bmoniey/FilamentMeasuringTool/gallery/as5600brd.png

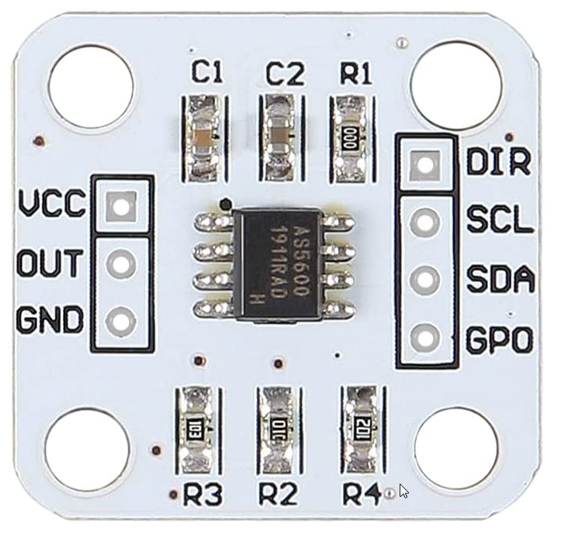
gallery/as5600brd.png
