bmoniey/FilamentMeasuringTool/gallery/display.png

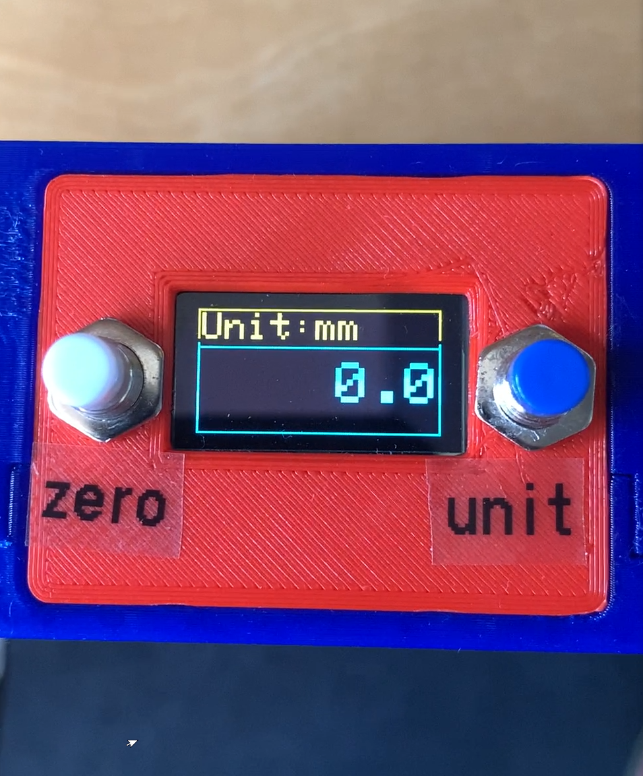
gallery/display.png
