bmoniey/FilamentMeasuringTool/gallery/fmt20_assy1.png

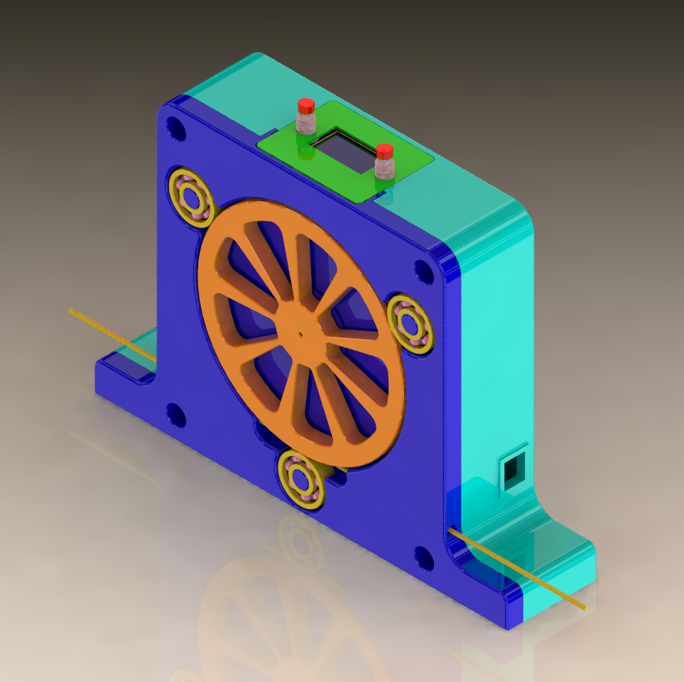
gallery/fmt20_assy1.png
