bmoniey/FilamentMeasuringTool/gallery/fmt20_assy2.png

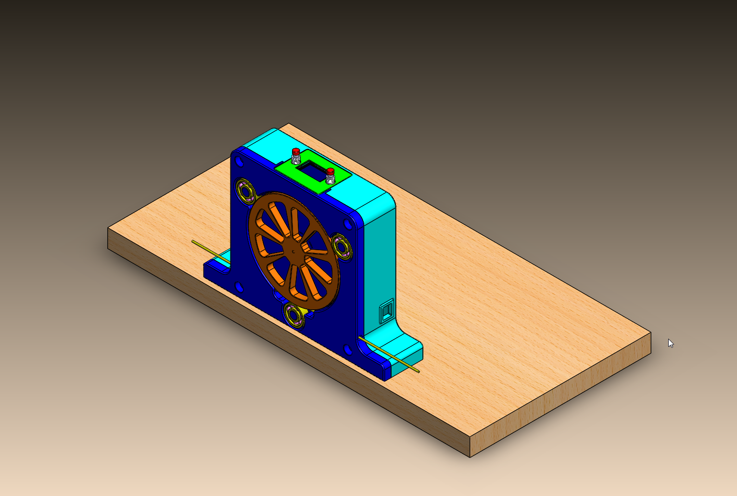
gallery/fmt20_assy2.png
