bmoniey/FilamentMeasuringTool/gallery/fmt20_assy3.png

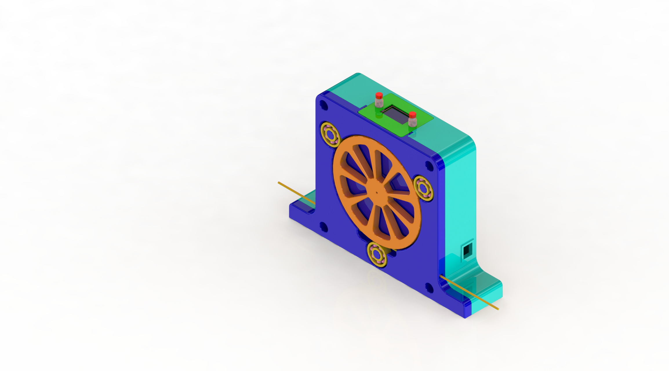
gallery/fmt20_assy3.png
