bmoniey/FilamentMeasuringTool/gallery/IMG_5166.jpg

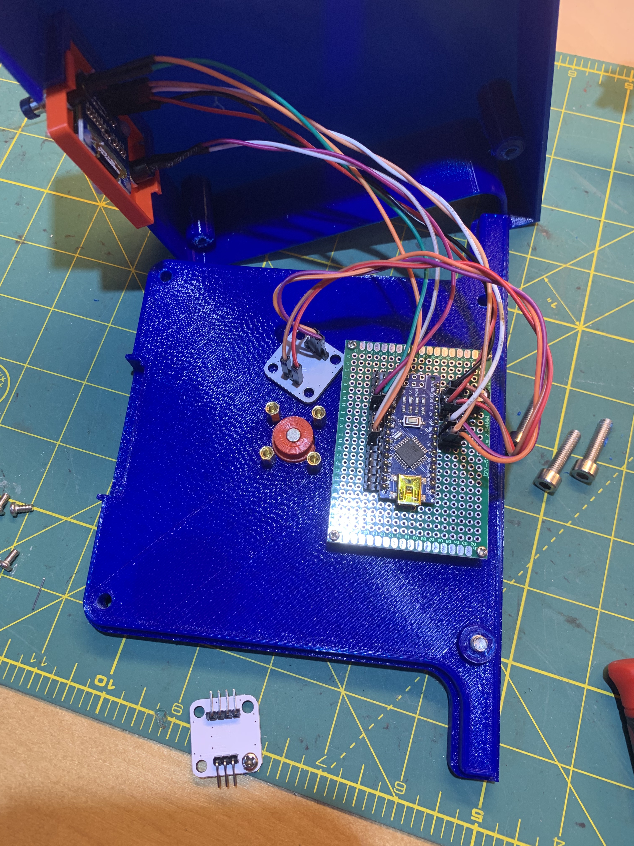
gallery/IMG_5166.jpg
