bmoniey/FilamentMeasuringTool/gallery/IMG_5167.jpg

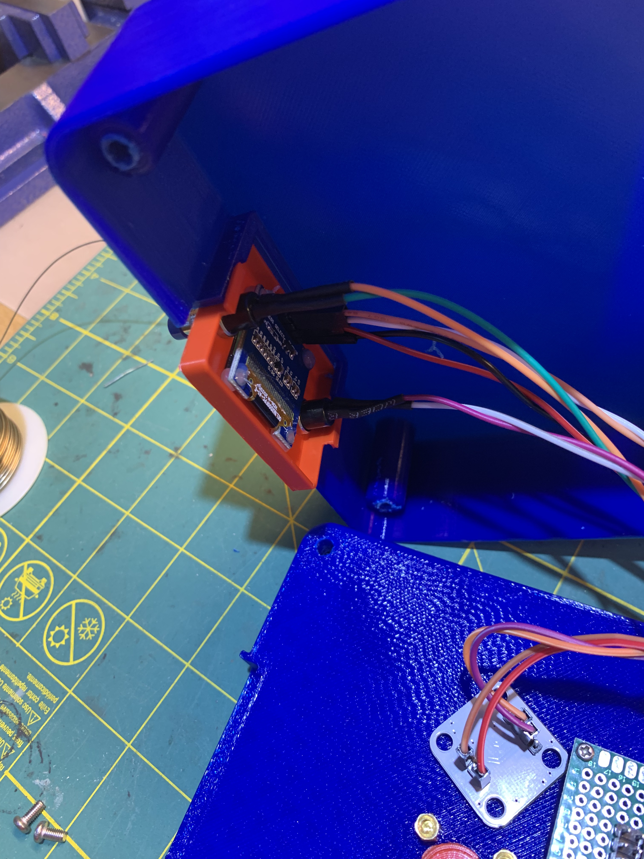
gallery/IMG_5167.jpg
