bmoniey/FilamentMeasuringTool/gallery/IMG_5168.jpg

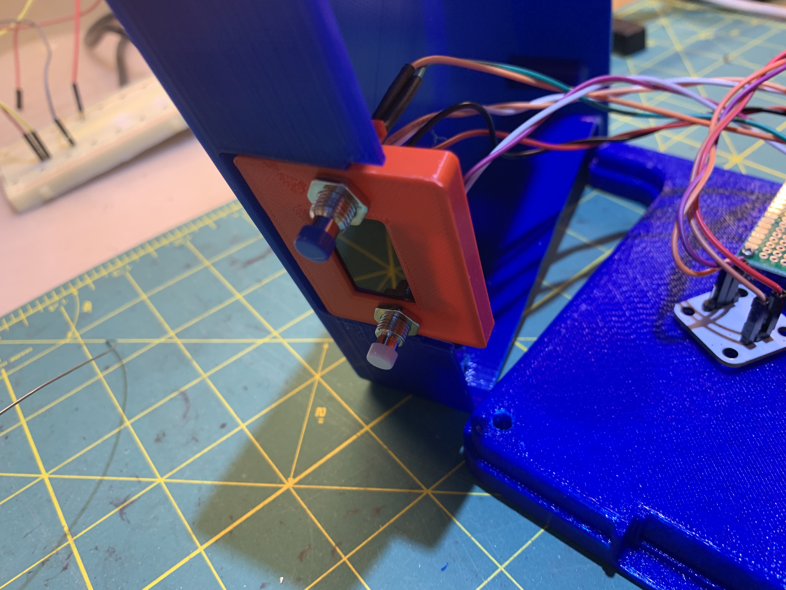
gallery/IMG_5168.jpg
