bmoniey/FilamentMeasuringTool/gallery/IMG_5169.jpg

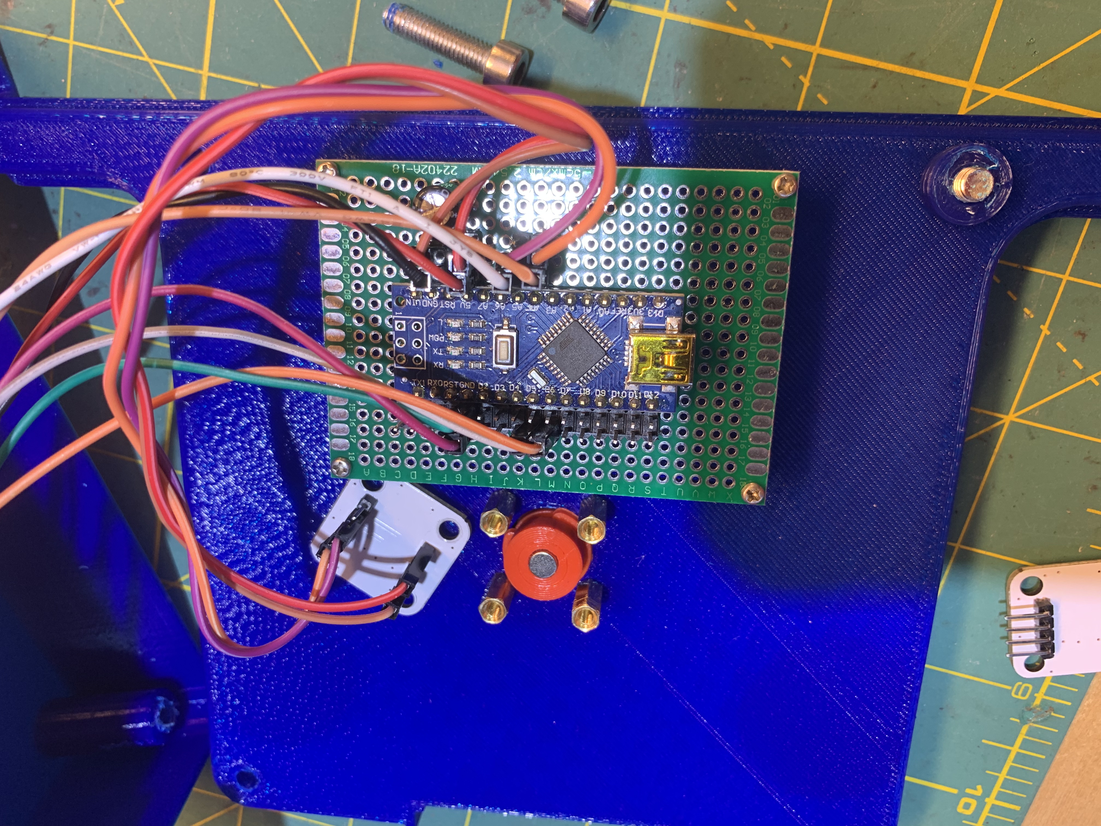
gallery/IMG_5169.jpg
