bmoniey/FilamentMeasuringTool/gallery/IMG_5171.jpg

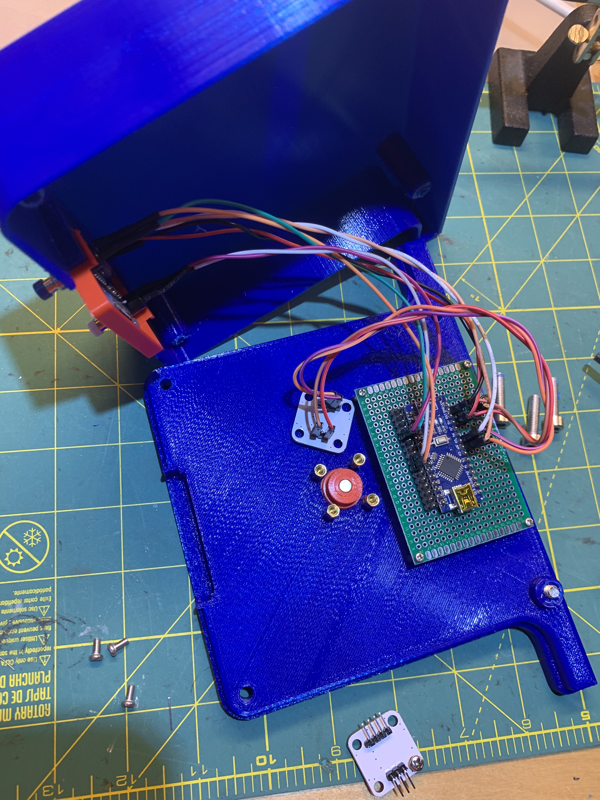
gallery/IMG_5171.jpg
