bmoniey/FilamentMeasuringTool/gallery/IMG_5173.jpg

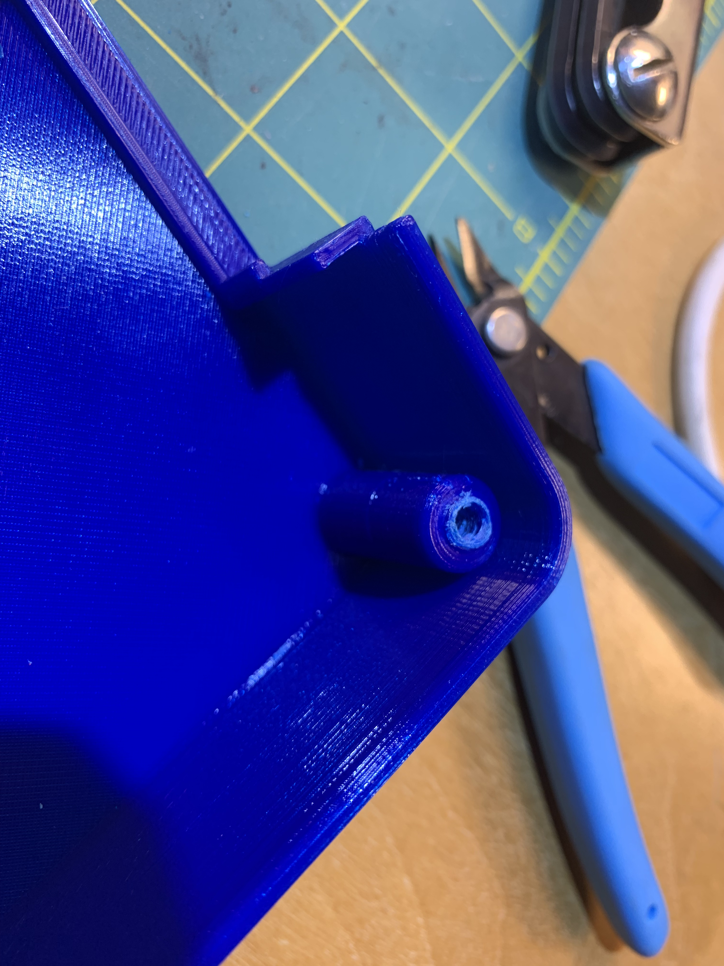
gallery/IMG_5173.jpg
