bmoniey/FilamentMeasuringTool/gallery/IMG_5174.jpg

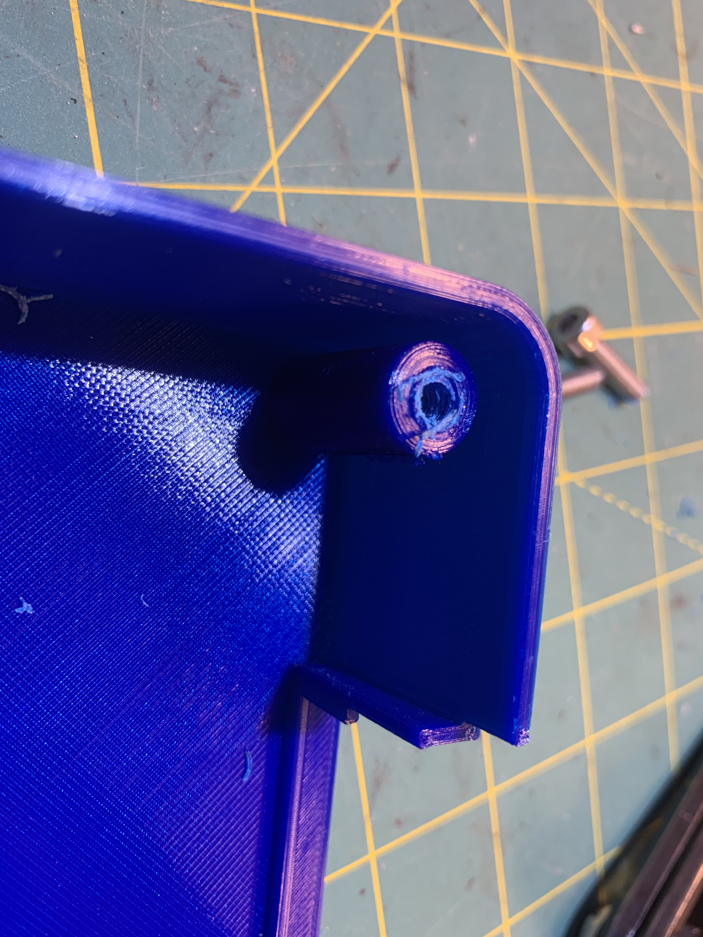
gallery/IMG_5174.jpg
