bmoniey/FilamentMeasuringTool/gallery/IMG_5178.jpg

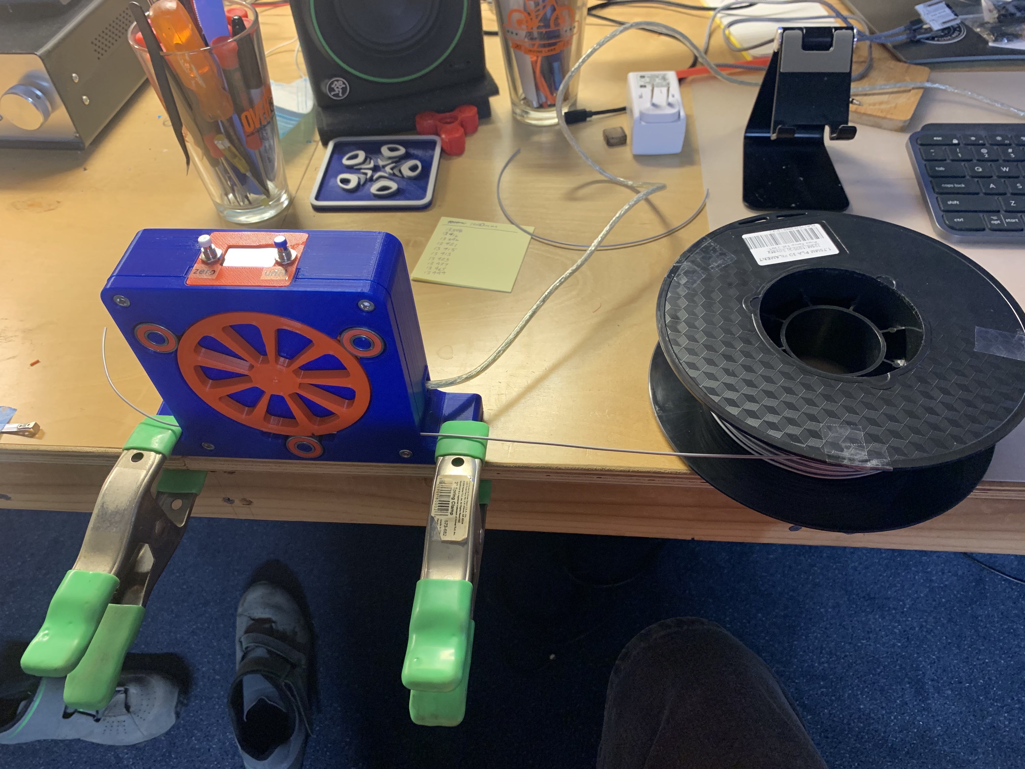
gallery/IMG_5178.jpg
