bmoniey/FilamentMeasuringTool/gallery/IMG_5179.jpg

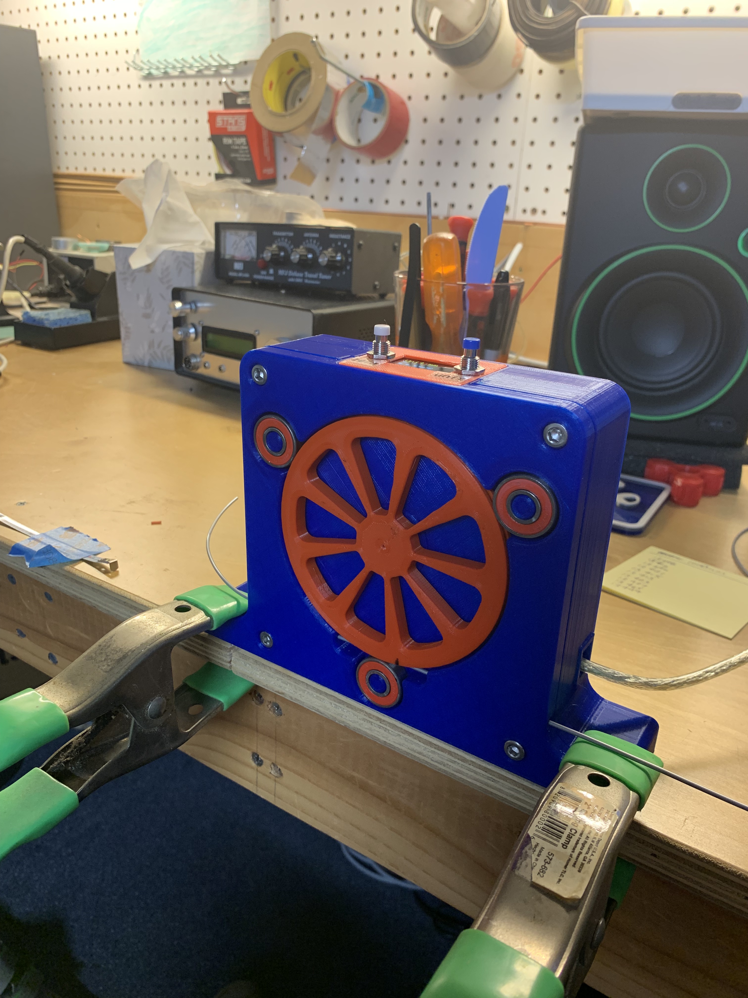
gallery/IMG_5179.jpg
