bmoniey/FilamentMeasuringTool/gallery/IMG_5180.jpg

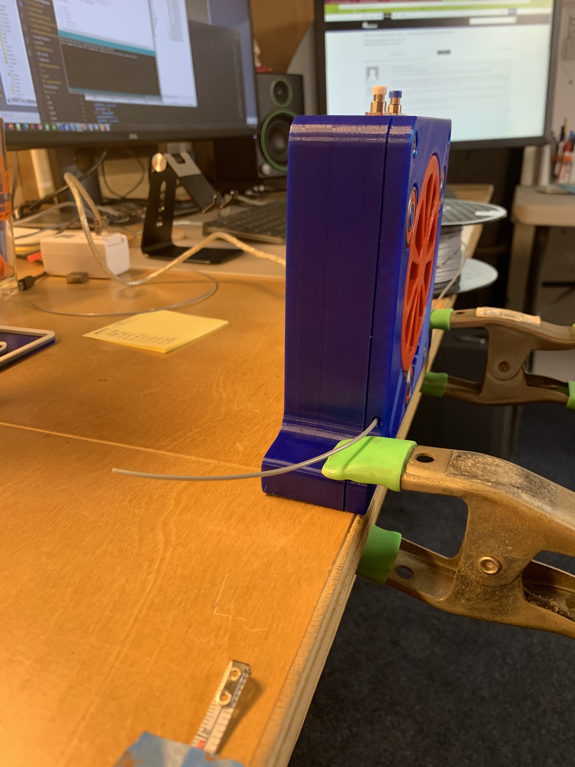
gallery/IMG_5180.jpg
