bmoniey/FilamentMeasuringTool/gallery/IMG_5181.jpg

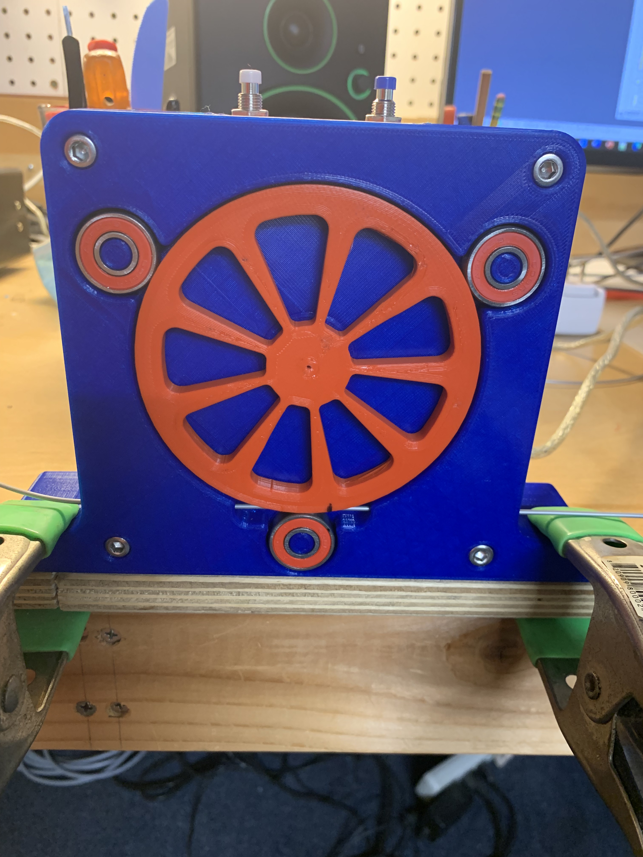
gallery/IMG_5181.jpg
