bmoniey/FilamentMeasuringTool/gallery/IMG_5182.jpg

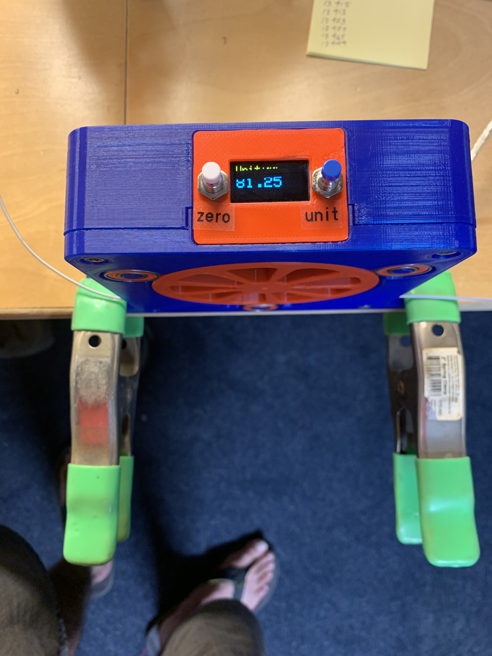
gallery/IMG_5182.jpg
