bmoniey/FilamentMeasuringTool/gallery/IMG_5183.jpg

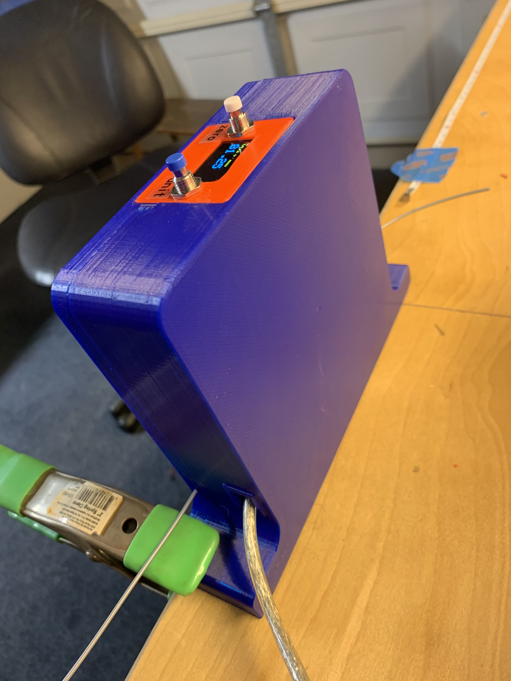
gallery/IMG_5183.jpg
