bmoniey/FilamentMeasuringTool/gallery/IMG_5184.jpg

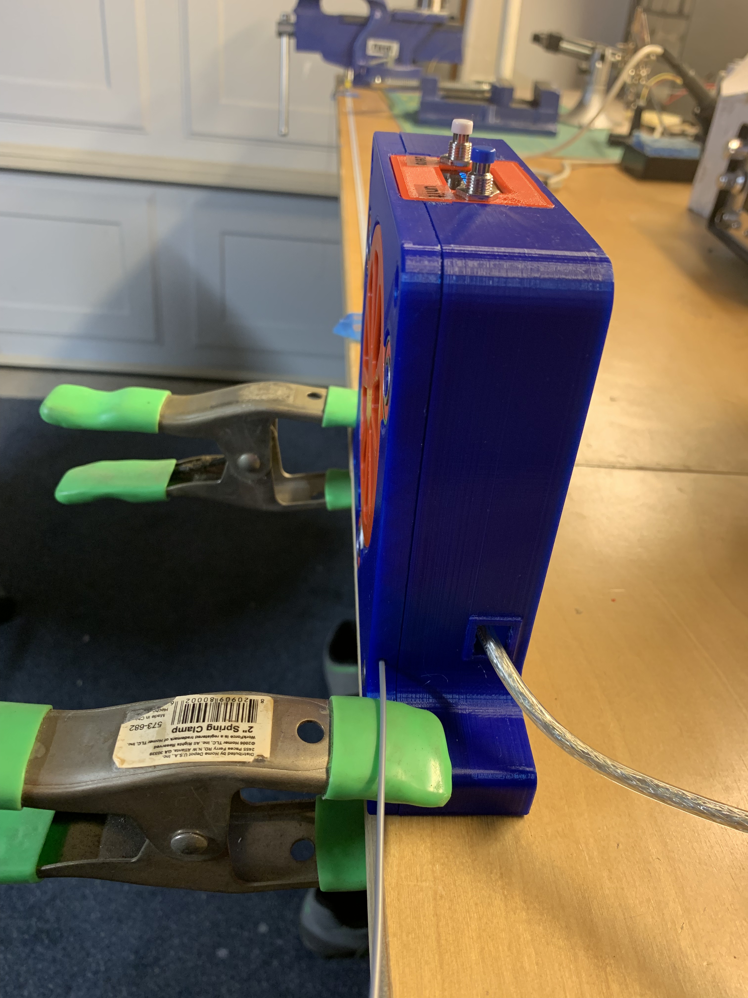
gallery/IMG_5184.jpg
