bmoniey/FilamentMeasuringTool/gallery/IMG_5185.jpg

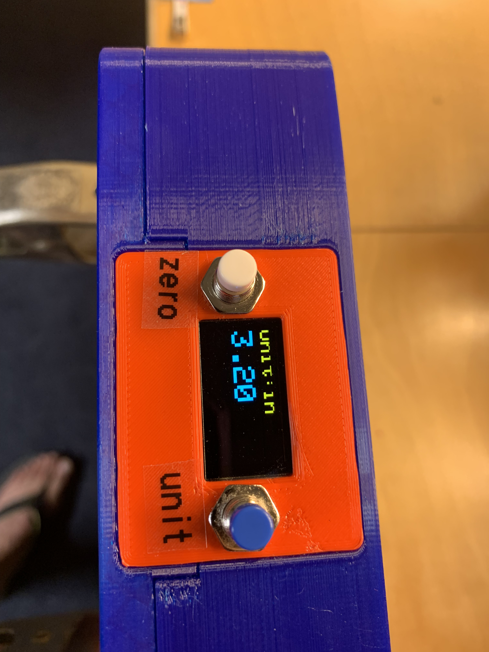
gallery/IMG_5185.jpg
