bmoniey/FilamentMeasuringTool/gallery/IMG_5186.jpg

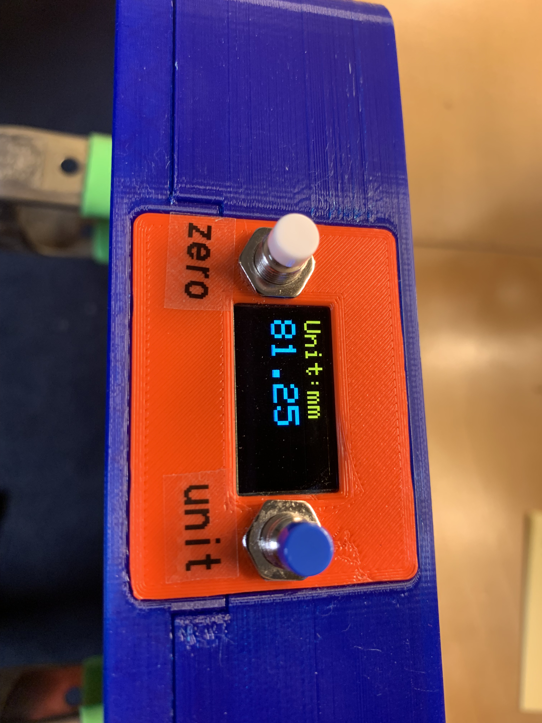
gallery/IMG_5186.jpg
