bmoniey/FilamentMeasuringTool/design/ecad/fmt.sch

## KiCad design design/ecad/fmt.sch (2021-10-02)

Schematic: fmt.sch

Parts:
A1: Arduino_Nano_v3.x; Arduino_Nano
C1, C2: 1uF
C8: 10uF
SW1: SW_RESET
SW2: SW_UNIT
U1: oled_128x64
U2: AS5600

Notes on the sheet:
Note: This is the reset to zero button. It does not reset the micro-controller
