bmoniey/FilamentMeasuringTool/(commit log)

2021-09-25 Building up for the inital push to the repo
    [fmt.sch]
2021-09-25 fixed link to schematic
2021-09-26 Version 2.1.0 -reads and writes calibration to eeprom -added calibration mode -added do_switches() which handles the button presses and the calibration mode
2021-09-27 added missin bom item for oled and added a couple part number references updated the version 2.1.1 release notes
2021-09-27 - removed unused variables and comments - created defines for magic numbers - improved handling of button presses - improved entry and return from calibration mode
2021-10-02 added bearing to BoM - Duh!
2021-10-02 updated BoM same as main branch
2021-10-02 added a note on bootup in the display. felt it was needed to track what code is on the device now that there are two branches. Also i jumped versions to reflect the major.git_revision.build formate i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
2021-10-02 Added 1uF caps to switches wich makes for a better user experience.
    [fmt.sch]
