bmoniey/FilamentMeasuringTool/gallery/IMG_5165.jpg

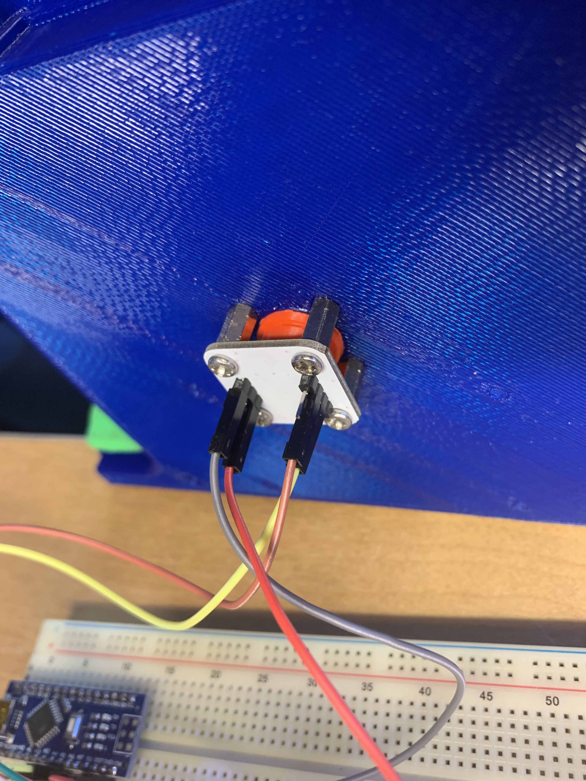
gallery/IMG_5165.jpg
