bmoniey/FilamentMeasuringTool/gallery/IMG_5172.jpg

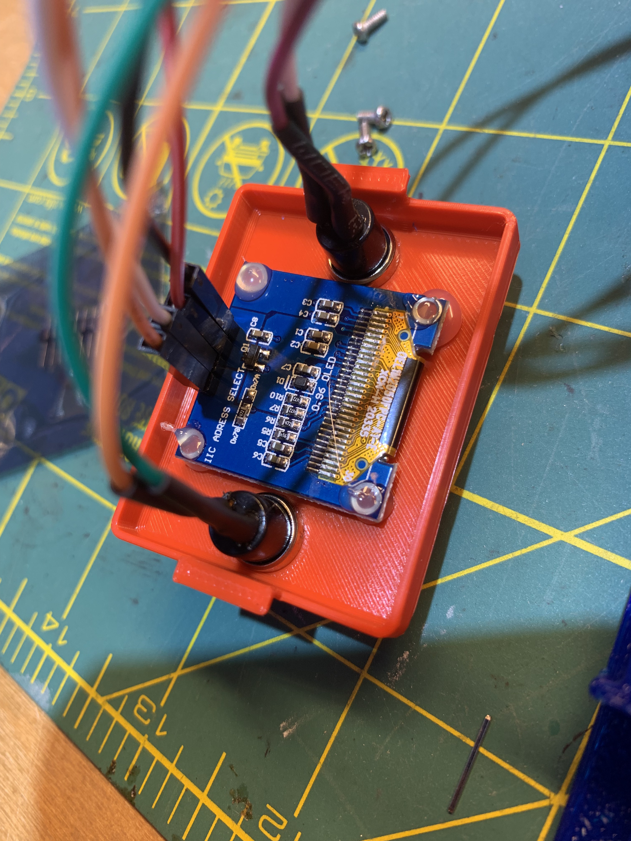
gallery/IMG_5172.jpg
