bmoniey/FilamentMeasuringTool/gallery/IMG_5175.jpg

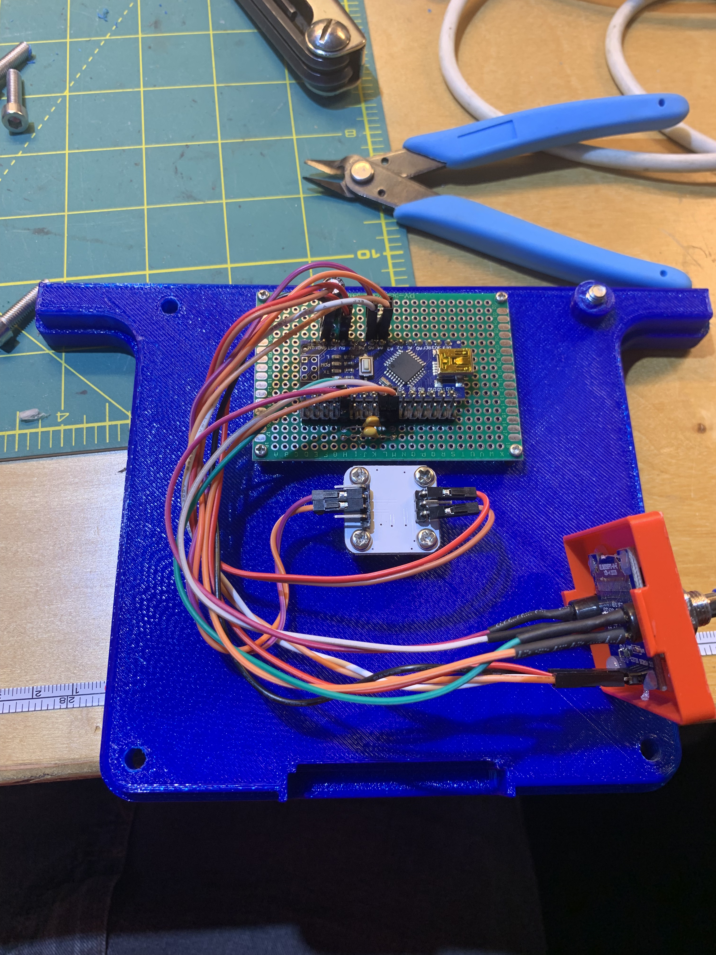
gallery/IMG_5175.jpg
